pmirandar/IEEELAT_LC_WM/Code/Readme.md

| Code | Description |
|--- | --- |
| water-level.gnu | This is the code that generates the water level graphs. It requires three input files named “System-N- Water_Level_per_hour”, where N is the system number. These files are located in the “Data” folder. (Fig. 7 (a))|
| daily_consumption.gnu | This is the code that generates the water daily consumption graphs. It requires three input files named “System-N-Daily-Water_Consumtion”, where N is the system number. These files are located in the “Data” folder. (Fig. 7 (b))|
| acummulated_consumption.gnu | This is the code that generates the water daily consumption graphs. It requires three input files named “System-N-Accumulated_Water_Consumption”, where N is the system number. These files are located in the “Data” folder. (Fig. 7 (c))|
| ConnectionStatus.py | This script reads the events of connectivity for three houses and gather all the information in a single plot. The necessary data is located in the “Data_c” folder. (Fig. 8)|
| Monitor_WL_WC-v0.6.9.ino | This is the firmware that allows the functionality of the hardware and is the most important piece of code in terms of reproduction of the system. |

# For the water level and consumption

Gnuplot is required; each code file must be in the same working directory as the corresponding input files. 

# ConnectionStatus.py 

To properly run this script, it is necessary to copy the Data_c folder into the working directory. The code defines a base directory:

```py
base_path = r"/home/pedro/Data_c"
```
So you need to modify this line to match your path. The packages needed to run the corresponding Python code are: 

- Pandas
- Matplotlib

# Monitor_WL_WC-v0.6.9.ino 

An ESP32-based IoT system designed for real-time monitoring of water tank level and water consumption. The device uses differential pressure sensors to estimate water level and a flow sensor to measure water usage. Data can be monitored locally through an LCD display or remotely through the Blynk platform.

## Features

* Real-time water level measurement using differential pressure sensors.
* Water consumption monitoring using a pulse-based flow sensor.
* Local visualization through a 20x4 I2C LCD.
* Remote monitoring using Blynk IoT.
* Automatic daily reset of consumption statistics.
* Offline operation when internet connectivity is unavailable.
* Dual-core processing using the ESP32 FreeRTOS architecture.
* Non-volatile memory storage for calibration offsets.
* Remote configuration of system parameters through the Blynk application.

---

## Hardware

### Microcontroller

* ESP32

### Sensors

* Two analog pressure sensors:

  * Air reference pressure sensor
  * Water pressure sensor
* Hall-effect flow sensor

### User Interface

* 20x4 LCD display (I2C)
* Zero-level calibration push button
* Display mode selection switch

### Connectivity

* Wi-Fi
* Blynk IoT Platform

---

## Pin Assignment

| Function | GPIO |
| --- | --- |
| Zero Level Button | GPIO25 |
| Display Mode Switch | GPIO26 |
| Flow Sensor | GPIO27 |
| Reset Input | GPIO33 |
| Air Pressure Sensor | GPIO34 |
| Water Pressure Sensor | GPIO35 |

---

## System Operation

### Water Level Measurement

The system continuously samples both pressure sensors and calculates the water column height using a differential measurement:

Level = k × (Vwater − Vair − Offset) / Vs

where:

* Vwater = water pressure sensor voltage
* Vair = atmospheric pressure sensor voltage
* Offset = stored zero reference
* Vs = sensor supply voltage
* k = calibration constant

The resulting level is displayed in meters and converted into a percentage of total tank capacity.

### Water Consumption Measurement

A pulse-based flow sensor is used to determine:

* Instantaneous flow rate (L/min)
* Total accumulated consumption (L)

Flow calculations are updated every second.

### Zero-Level Calibration

Pressing the calibration button stores the current differential pressure value as a reference offset. The offset is saved in the ESP32 non-volatile memory and remains available after power cycles.

### Daily Consumption Reset

Using the Blynk RTC service, the system automatically resets daily water consumption counters at midnight.

---
## Blynk Configuration

Create your own Blynk Template and replace the placeholder values in the source code:

```cpp
#define BLYNK_TEMPLATE_ID "YOUR_TEMPLATE_ID"
#define BLYNK_TEMPLATE_NAME "YOUR_TEMPLATE_NAME"
```

Configure the following virtual pins:

| Virtual Pin | Function |
| --- | --- |
| V0 | Water level (m) |
| V1 | Tank filling percentage (%) |
| V3 | Tank height configuration (m) |
| V4 | Sensor supply voltage (V) |
| V5 | Instantaneous flow rate (L/min)  |
| V6 | Total water consumption (L) |
| V8 | Flow sensor calibration constant |
| V9 | Previous day consumption |
| V11 | Air pressure sensor voltage |
| V12 | Water pressure sensor voltage |

A good source of information can be found in:

[Blynk Manual](https://docs.blynk.io/en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)

---

## Software Architecture

The firmware uses both ESP32 cores:

### Core 0

Handles:

* Blynk communication
* Wi-Fi management
* Timer execution
* Cloud synchronization

### Core 1

Handles:

* Sensor acquisition
* Signal processing
* Flow calculations
* LCD updates

This architecture allows measurement tasks to continue operating even when network communication is interrupted.

---

## Main Libraries

* BlynkEdgent
* LiquidCrystal_I2C
* TimeLib
* WidgetRTC
* Preferences

  Install the libraries through Arduino IDE Library Manager before compiling.
