pmirandar/IEEELAT_LC_WM/Diagram/Schem.png

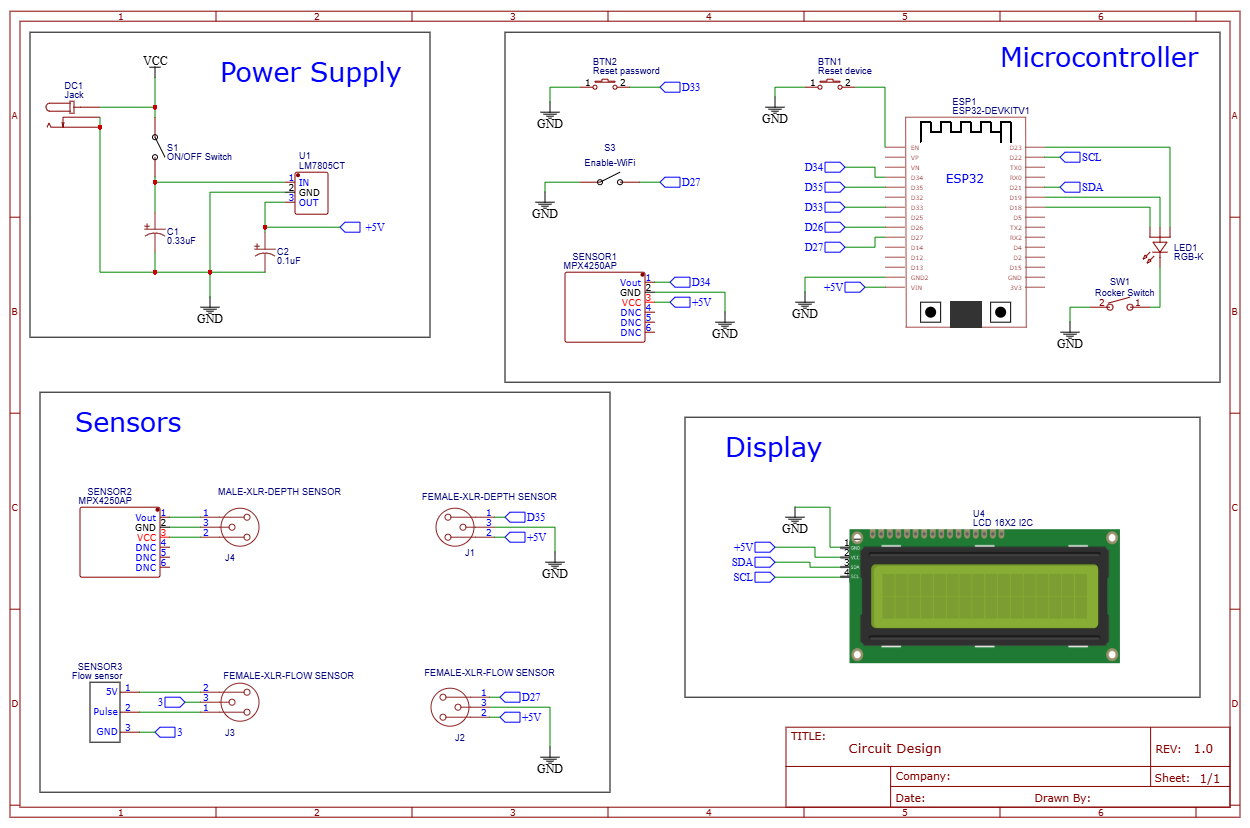
Diagram/Schem.png
