pmirandar/IEEELAT_LC_WM/Images_app/System-1-interface-1.jpg

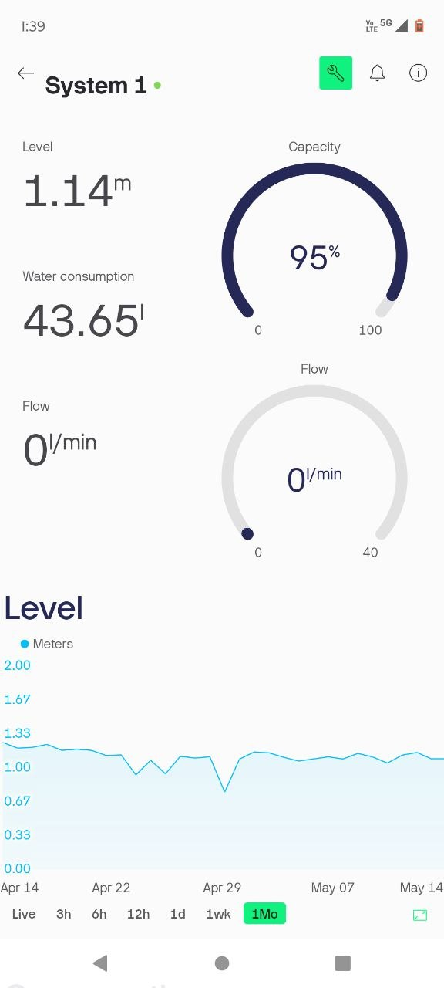
Images_app/System-1-interface-1.jpg
