pmirandar/IEEELAT_LC_WM/Images_app/System-1-interface-2.jpg

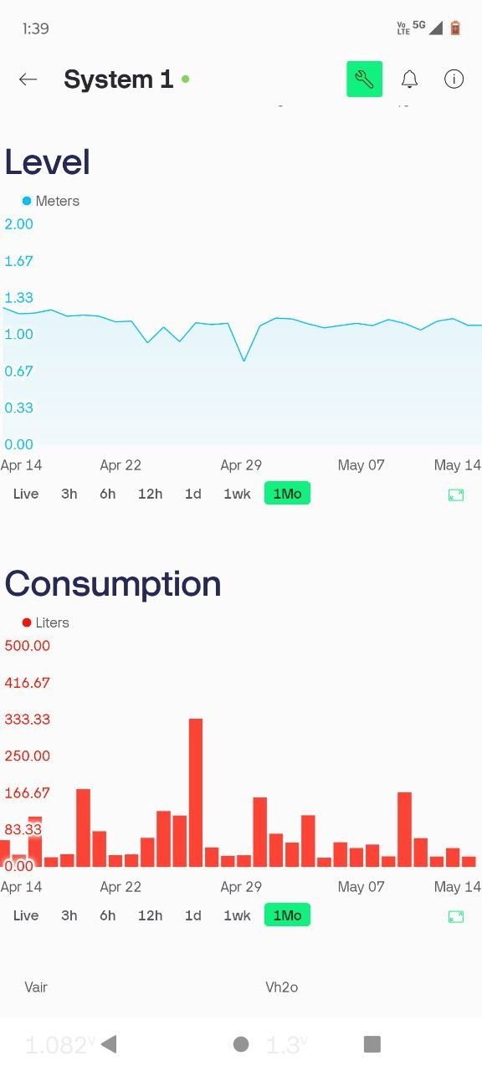
Images_app/System-1-interface-2.jpg
