pmirandar/IEEELAT_LC_WM/Images_app/System-2-interface-1.jpg

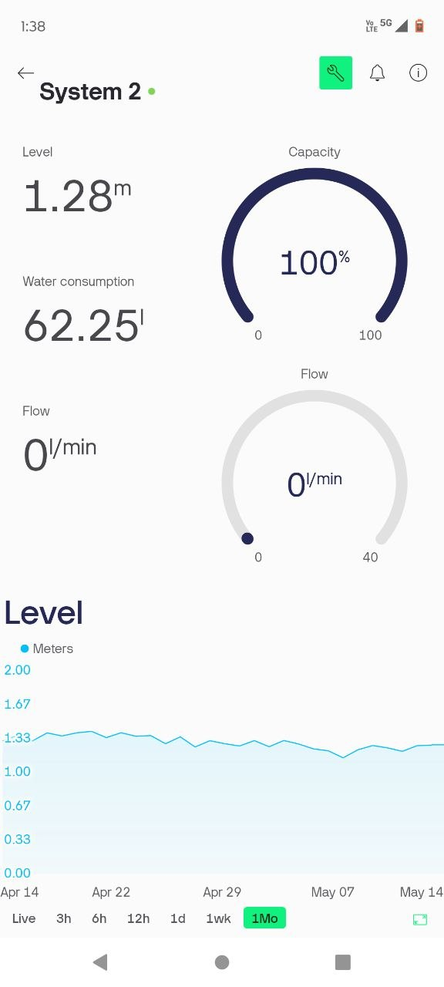
Images_app/System-2-interface-1.jpg
