pmirandar/IEEELAT_LC_WM/Images_app/System-2-interface-2.jpg

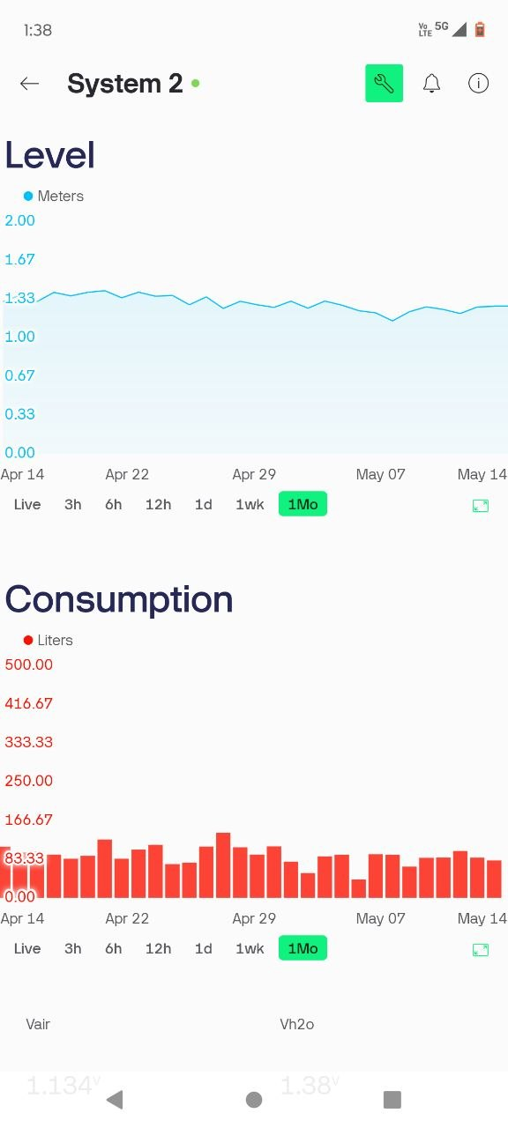
Images_app/System-2-interface-2.jpg
