pmirandar/IEEELAT_LC_WM/Images_app/System-3-interface-1.png

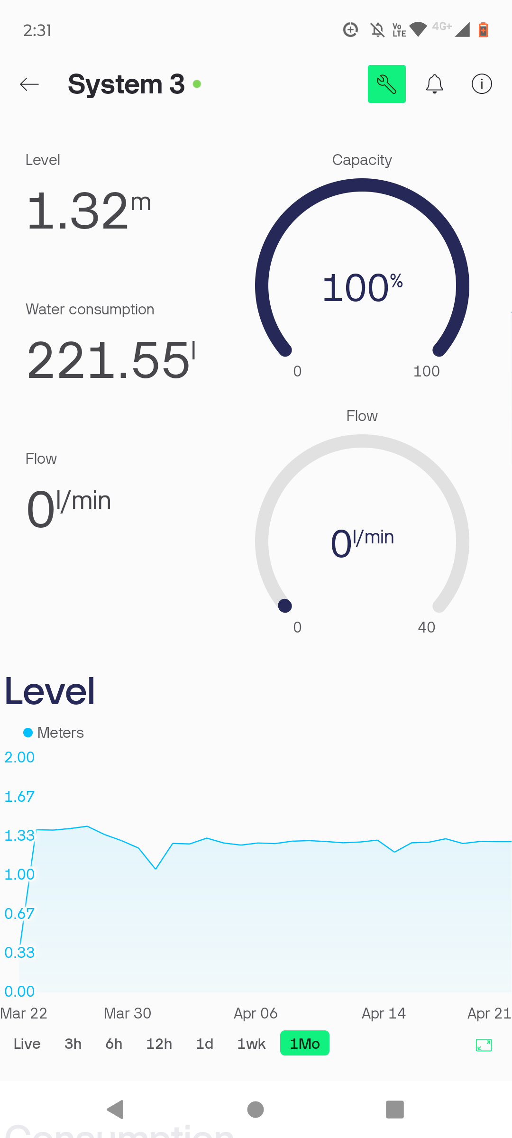
Images_app/System-3-interface-1.png
