pmirandar/IEEELAT_LC_WM/Code/Monitor_WL_WC-v0.6.9.ino

#define BLYNK_TEMPLATE_ID "YOUR_TEMPLATE_ID"
#define BLYNK_TEMPLATE_NAME "YOUR_TEMPLATE_NAME"
#define BLYNK_FIRMWARE_VERSION "0.6.9"

#define BLYNK_PRINT Serial
#define APP_DEBUG

#include "BlynkEdgent.h"
#include <LiquidCrystal_I2C.h>
#include <TimeLib.h>
#include <WidgetRTC.h>
#include <Preferences.h>

Preferences preferences; // object for reading from/writing to non-volatile memory

// Pines 
#define boton 25
#define pantalla 26
#define FLOW_SENSOR_PIN 27
#define rst 33
#define aire 34
#define agua 35

// Global variables for storing data
volatile double Level_sum = 0;
volatile double Vair_sum = 0;
volatile double Vh2o_sum = 0;
volatile int Level_count = 0;
volatile double nivelOffset = 0;
volatile bool resetRequest = false; // to handle the button press event

// Resetting the liter counter
WidgetRTC rtc;

int ultimoDiaReset = -1;

// Water level
volatile double Level;
volatile int porcentaje;
double total = 1.2;
volatile double Vair;
volatile double Vh2o;
double Vs = 5.00;
double slope = 38.672;
const float c = 0.982;
const float b = 0.126;

// Flow
volatile int flow_frequency;
volatile int flow_frequency_2;
volatile unsigned long pulsos = 0;
volatile float l_min;
volatile float Liters;
float cte = 6.6;
float m = 0.72;
unsigned long tiempoAnterior = 0;
volatile float flujo_Lmin = 0;
volatile float litros_totales = 0;
unsigned long currentTime;
unsigned long cloopTime;
bool habiaFlujo = false;

void IRAM_ATTR contarPulsos()
{
  pulsos++;
}

void IRAM_ATTR botonReset()
{
  resetRequest = true; // It simply indicates that a reset was requested
}

// LCD
bool modo = 0;
LiquidCrystal_I2C lcd(0x27, 20, 4);

// Timer Blynk
BlynkTimer timer;

// Blynk
void myTimer()
{
  double Level_avg = 0;
  double Vair_avg = 0;
  double Vh2o_avg = 0;

  if (Level_count > 0)
  {
    Level_avg = Level_sum / Level_count;
    Vair_avg = Vair_sum / Level_count;
    Vh2o_avg = Vh2o_sum / Level_count;
  }

  // Rounding 
  Level_avg = round(Level_avg * 100.0) / 100.0;
  Vair_avg = round(Vair_avg * 1000.0) / 1000.0;
  Vh2o_avg = round(Vh2o_avg * 1000.0) / 1000.0;

  // Reset accumulators
  Level_sum = 0;
  Vair_sum = 0;
  Vh2o_sum = 0;
  Level_count = 0;

  // Submit average level
  Blynk.virtualWrite(V0, Level_avg);

  // Submit average percentage
  int porcentaje_avg = total > 0 ? round(Level_avg * 100.0 / total) : 0;
  Blynk.virtualWrite(V1, porcentaje_avg);

  // Submit average voltages
  Blynk.virtualWrite(V11, Vair_avg);
  Blynk.virtualWrite(V12, Vh2o_avg);

  // DAILY RESET IN LITERS
  int hora = hour();
  int minuto = minute();
  int diaActual = day();

  if (hora == 0 && minuto == 0 && diaActual != ultimoDiaReset)
  {
    Blynk.virtualWrite(V9, Liters); // Optional: Save liters from the previous day

    Liters = 0;
    flow_frequency_2 = 0;
    ultimoDiaReset = diaActual;

    Serial.println("Reinicio diario de litros");
  }
}

void sendFlowRealtime()
{
  bool hayFlujo = l_min > 0; // noise barrier

  if (hayFlujo)
  {
    // As long as there is flow, always send
    Blynk.virtualWrite(V5, l_min);
    Blynk.virtualWrite(V6, Liters);
    habiaFlujo = true;
  }
  else if (habiaFlujo)
  {
    // Only once, when the flow drops to zero
    Blynk.virtualWrite(V5, 0);
    habiaFlujo = false;
  }
}

// BLYNK_WRITE 
BLYNK_WRITE(V3) { total = param.asDouble(); }
BLYNK_WRITE(V4) { Vs = param.asDouble(); }
BLYNK_WRITE(V8) { cte = param.asDouble(); }

// Flow interruption
void flow()
{
  flow_frequency++;
  flow_frequency_2++;
}

// Measurement Module and LCD (Core 1)
void TaskMedicion(void *pvParameters)
{
  double aux1, aux2;
  const int n = 200;

  for (;;)
  {
    // Sensor Readings 
    aux1 = 0;
    aux2 = 0;
    for (int i = 0; i < n; i++)
    {
      aux1 += analogRead(aire) * 3.3 / 4095.0;
      aux2 += analogRead(agua) * 3.3 / 4095.0;
      vTaskDelay(10 / portTICK_PERIOD_MS);
    }
    Vair = aux1 / n;
    Vh2o = aux2 / n;

    Vair = c * Vair + b;
    Vh2o = c * Vh2o + b;

    Vair = round(Vair * 1000.0) / 1000.0;
    Vh2o = round(Vh2o * 1000.0) / 1000.0;

    // Level calculation
    if (resetRequest)
    {
      nivelOffset = (Vh2o - Vair); // We'll keep the current difference
      resetRequest = false;
      Serial.println("Nivel reseteado a cero, offset guardado: " + String(nivelOffset));
      preferences.begin("MedidorAgua", false);
      preferences.putDouble("offset", nivelOffset); // nivelOffset save
      preferences.end();
    }

    Level = slope * (Vh2o - Vair - nivelOffset) / Vs;
    Level = round(Level * 100.0) / 100.0;
    if (Level < 0)
      Level = 0;
    porcentaje = Level * 100 / total;

    // Aggregate over an average of 1 minute
    Level_sum += Level;
    Vair_sum += Vair;
    Vh2o_sum += Vh2o;
    Level_count++;

    // Calculating flow per second
    // Flow Measurement
    currentTime = millis();
    // Every second, calculate and print litres/min
    if (currentTime >= (cloopTime + 1000))
    {
      cloopTime = currentTime; // Updates cloopTime

      // Pulse frequency (Hz) = 7.5Q, Q is flow rate in L/min.
      l_min = (flow_frequency / cte);
      // (Pulse frequency x 60 min) / 7.5Q = flowrate in L/hour

      flow_frequency = 0; // Reset Counter
      Liters = flow_frequency_2 / cte / 60 / 1.4 / m;
    }

    // LCD Update
    lcd.clear();
    lcd.setCursor(0, 0);

    if (digitalRead(pantalla) == LOW)
    {
      lcd.print("Capacidad: ");
      lcd.setCursor(12, 0);
      lcd.print(porcentaje);
      lcd.setCursor(15, 0);
      lcd.print("%");
      lcd.setCursor(0, 1);
      lcd.print("Nivel: ");
      lcd.setCursor(10, 1);
      lcd.print(Level, 2);
      lcd.setCursor(15, 1);
      lcd.print("m");
    }
    else
    {
      lcd.print(l_min, 2);
      lcd.print(" L/min");
      lcd.setCursor(0, 1);
      lcd.print(Liters, 2);
      lcd.print(" L");
      lcd.setCursor(12, 1);
      lcd.print(porcentaje);
      lcd.setCursor(15, 1);
      lcd.print("%");
    }
  }
}

// --- Setup ---
void setup()
{
  Serial.begin(115200);

  // Pines
  pinMode(boton, INPUT_PULLDOWN);                                    
  attachInterrupt(digitalPinToInterrupt(boton), botonReset, RISING); 
  pinMode(rst, INPUT_PULLUP);
  pinMode(pantalla, INPUT_PULLUP);
  pinMode(agua, INPUT_PULLDOWN);
  pinMode(FLOW_SENSOR_PIN, INPUT_PULLUP);
  digitalWrite(FLOW_SENSOR_PIN, HIGH);
  attachInterrupt(digitalPinToInterrupt(FLOW_SENSOR_PIN), flow, FALLING);
  sei(); // Enable interrupts
  currentTime = millis();
  cloopTime = currentTime;

  // LCD
  lcd.init();
  lcd.backlight();
  lcd.clear();
  lcd.setCursor(0, 0);
  lcd.print("Iniciando...");

  // Blynk
  BlynkEdgent.begin();

  // Measurement task + LCD on core 1
  xTaskCreatePinnedToCore(
      TaskMedicion, "MedicionLCD", 4096, NULL, 1, NULL, 1);

  // Blynk timers  
  timer.setInterval(60000L, myTimer);
  // 1-second timer for real-time flow
  timer.setInterval(1000L, sendFlowRealtime);

  lcd.clear();
  lcd.setCursor(0, 0);
  lcd.print("Sistema listo");
}

// Blynk Connected
BLYNK_CONNECTED()
{
  rtc.begin(); // synchronize the time with the Internet

  lcd.clear();
  lcd.setCursor(0, 0);
  lcd.print("Conectado con");
  lcd.setCursor(0, 1);
  lcd.print("exito!");
  delay(2000);
}

// Main loop (core 0)
void loop()
{
  BlynkEdgent.run();
  timer.run();
}
